JanusTan/robot_4_drawingpic/ACS6502 2019-20 Sem 1 Group Project Final Report Group 16.pdf

ACS6502 2019-20 Group Project Final Report

### ACS6502 Group Project Final Report

Group number 16, Domain 1, Autonomous systems

## Self - Drawing Manipulator

Ming Zhou, Zhaoda Du, Jiannan Tan ABSTRACT — The aim of this project is to design a manipulator that can draw picture according to the user's needs. The user only needs to insert an image file in the user interface, and the manipulator can draw it on the paper. Manipulator is now used in many fields, such as industrial production and medical treatment. It can accomplish many tasks that human beings can't, characterized by high precision, large load and long continuous operation time. In order to realize the drawing function of the manipulator in this project, the problems faced are: mechanical and electronic design, the image processing, how to control the joint of the manipulator so that it can accurately guide the end-effector (such as pen) to the corresponding position. The system is divided into two parts, image processing and servo motor control. To assess the performance of the design, a random 30-person survey was conducted. The result is quite successful. The project can improve for other functions, only thing need to replace the end-effector.

### 1. INTRODUCTION

With the development of computer imaging, the traditional drawing tools have changed. Computer graphics has become a mainstream productivity tool. But ink-pan painting is still very popular in the field of art [1]. It has its own unique artistic value. Many people dream of creating their own ink-pan paintings, but it is very difficult to master such a skill. Even some artists often spend a lot of time to create ink-pan paintings. With this motivation, the group decided to develop a drawing manipulator that can realize the creation of ordinary people's ink-pan painting. There are many similar projects in the field of robot drawing. For example, ISAC [2] learns to draw by tracking human hand movements. Draw-Bot [3] analyzes and records the force between pen and paper to learn how to draw. Both of the above projects have a similar feature. It is necessary to learn the artist's painting process before drawing an ink-pan painting. The disadvantage is that such robots can only draw a single ink-pan painting, which can’t meet the flexible needs of ordinary users. In addition, the drawing manipulator can also be used for drawing education. The beginners can learn some drawing skills by repeatedly observing the drawing track of the manipulator. For example, a drawing education mechanical arm developed with Lego building blocks [4].

### 2. DEVELOPED SYSTEM

### 2.1 OVERVIEW OF THE SYSTEM

Fig. 1 presents the CAD design of the drawing robot system. The arm 1 and arm 2, which are controlled by motor 1 and motor 2 respectively, should move from 0° to 179°. Before the manipulator begins to draw, the end-effector would be pressed down by the motor 3. After the manipulator completes a continuous curve, the end-effector would be lifted by the motor 3 and prepares for the next point.

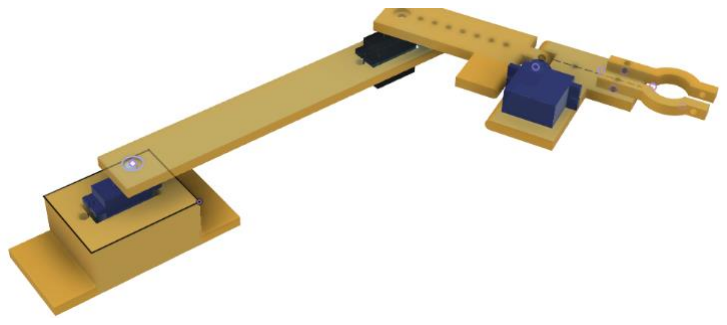
[picture p1: figure]

Fig. 1. Overview of the CAD design of the system.

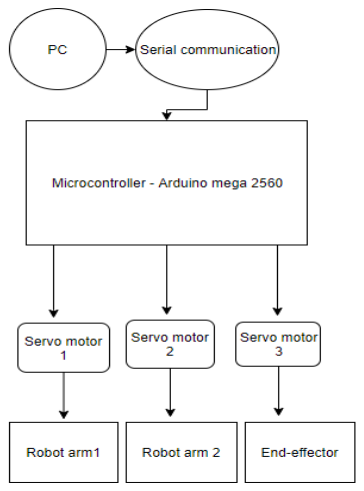
[picture p2: figure]

Fig. 2. Components relation diagram describing the system’s functional structure.

Fig 2. shows the connection between the joints and MCU to realize the mechatronic behaviour that draws pictures on paper. After the picture was processed by PC or other microcontrollers, the coordinates of the picture would be sent to Arduino Mega 2560 via serial communication.

### 2.2 MECHANICAL DESIGN

All mechanical parts in this project are manufactured by 3D printer with PLA material. The 3D model is designed from Fusion 360. The appearance of the real manipulator shows in Fig.3 below.

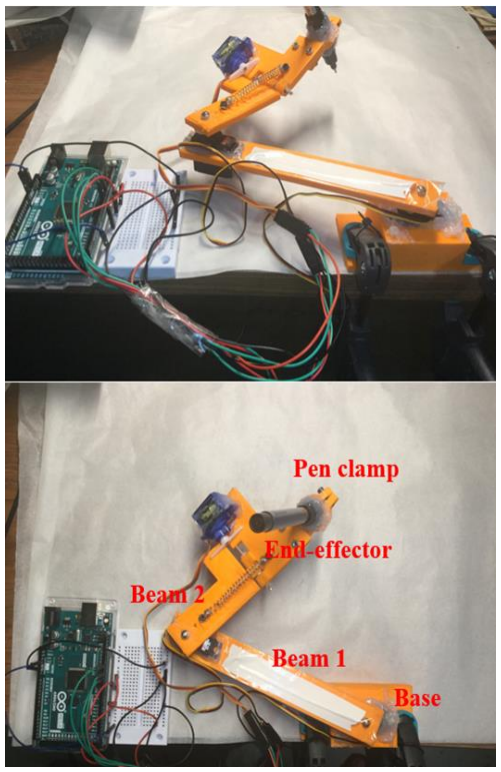
[picture p3: figure]

Fig. 3. The real Mechanical design of this manipulator.

This manipulator contains 5 parts, they are Base, Beam 1, Beam 2, End-effector and Pen clamp(They have been marked named in Figure 1). They can be viewed separately in fusion 360 and the parameters of each part shown in Fig. 4 (top view parameters) and Fig. 5 (side view parameters). (they have been put in appendix)

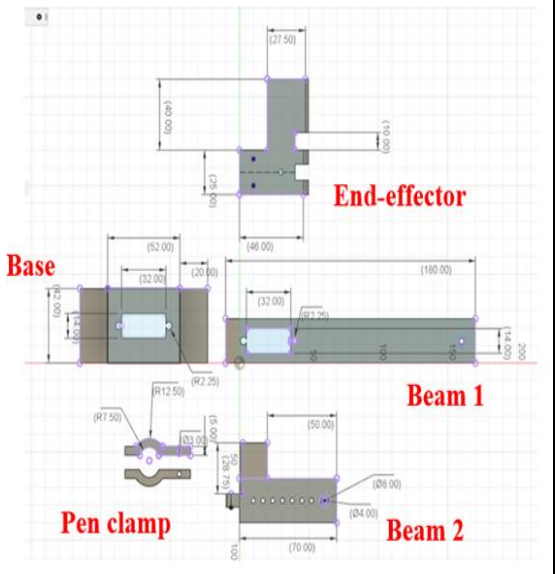
[picture p4: figure]

Fig. 4. Top view parameters of each part.

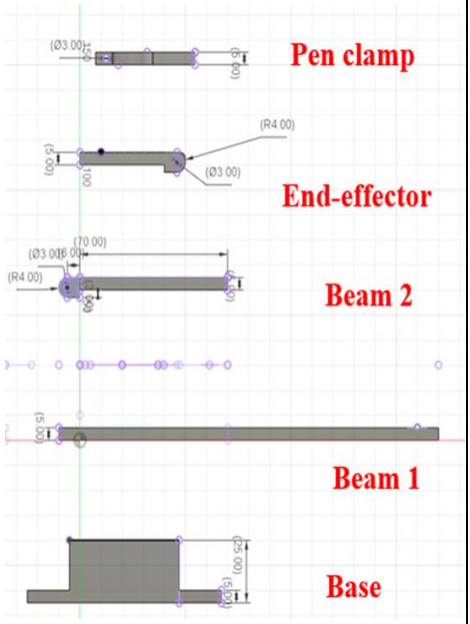
[picture p5: figure]

Fig. 5. Side view parameters of each part.

To assemble the parts, screws and hot gun have been used. The structure of this manipulator is strong enough to operate. A spring has been connected between end-effector and beam 2, that’s why there are many holes in the centre of beam 2, spring can be stretch according to the torque of the motor on end-effector.

### 2.3 ELECTRONICS DESIGN

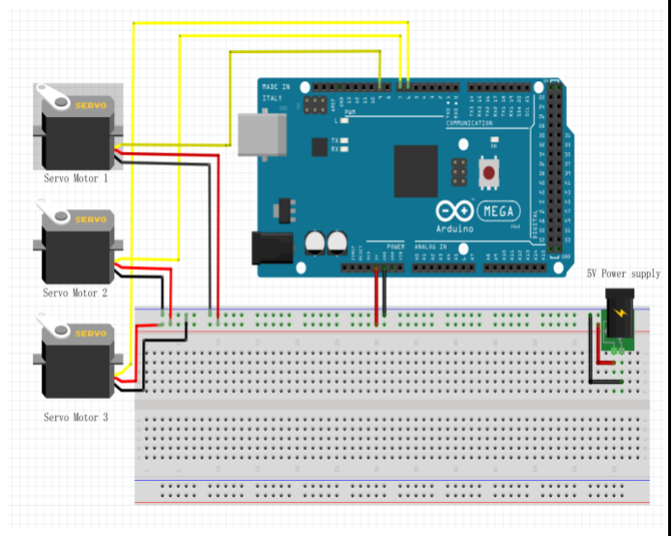
[picture p6: figure]

Fig. 6. Schematic and photo of the circuit.

Fig 6. shows the circuit of the system. Two Servo motors (HS-81) [5] have been selected for joint 1 and joint 2, respectively. The torque for these two
motors | was | 3 | kg·cm | which | satisfies | the
requirements for driving the weights (80g±2g) of all robot arms and a pen. The torque of another servo motor (SG90) [6] for joint 3 was 2.5 kg·cm. Because the motor for joint 3 was used for pressing down or lifting the pen, the requirement of the torque for implementing this operation is smaller than previous joints. Hence, using this servo motor is sufficient.

### 2.4 BEHAVIOUR DESIGN

In this project, inverse kinematic will be used. The equation of inverse kinematic shows as below.

Where:

θ1 is the turning angle of the motor at joint 1;

θ2 is the turning angle of the motor at joint 2;

l1 is the length from the first joint to the second joint;

l2 is the length from the second joint to pin of the pen;

x and y are the coordinates of
the pen.

l1, l2 are constant values and they are 145mm and 125mm.x and y are required input variables in this equation.

The working process of this project can be expressed in following Flowchart in Fig.7

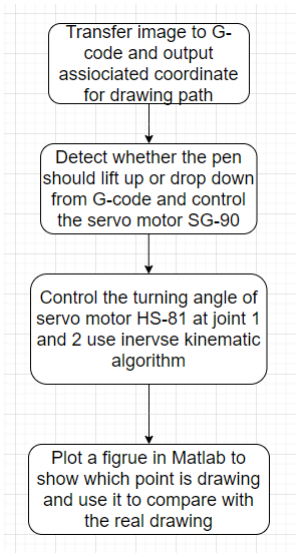
[picture p7: figure]

Fig. 7. Flow chart of the main algorithm

According to Fig.7, this project contains four parts.

Firstly, no matter what image has been downloaded from the website, the image will be put into a code (details of code please check Appendix) to transfer the image to G-code and therefore edge of the image will be detected. The coordinates (x, y) of points on edge will be put into a matrix, the matrix then separated into different paths. At the start of each path, a string ‘M3’ will be recorded and at the end of each path, a string’M5’ will occurs. Example of output data can be viewed in Fig. 8. G1 in Fig.8 means on the path. G90 means the start of the whole drawing process. A back up plan incase this code runs any problem in tests is to use a G-code software called ‘laser GRBL’.

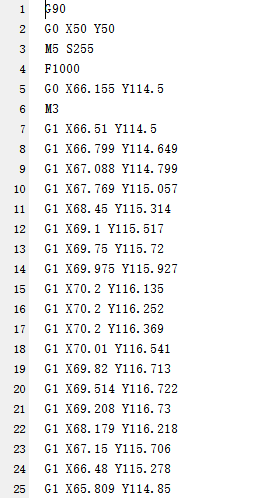
[picture p8: figure]

Fig. 8. Example of output data.

Secondly, string ‘M3’ and ‘M5’ will tell the SG90 motor to drop the pen down or lift the pen up. ‘M3’ means start drawing a new path, therefore pen should be drop down on the paper when’M3’ detected. On the contrast, ‘M5’ means lift the pen up to leave the paper and move to the start point of next point. (check the second code in Appendix)

Thirdly, the rotation angles of HS 81 servo motors will be controlled use inverse kinematic. (second code in Appendix).

Fourthly, a figure will be plot through the Matlab, to monitor the process by add point to this figure when running the manipulator. Fig. 9 is example of the plot figure. This is a minor of real figure.

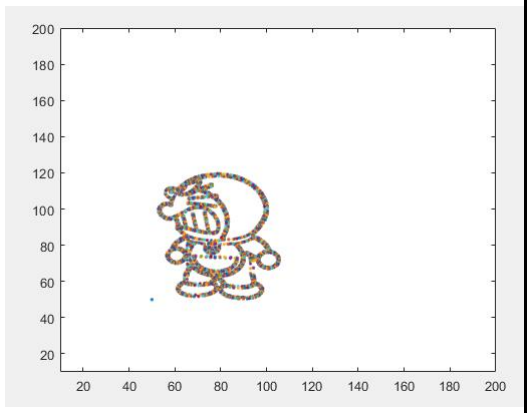
[picture p9: figure]

Fig. 9. Example of plot during process.

### 2.5 CHARACTERISATION

The particularity of this design is that it can't evaluate the result with intuitive data. The group chose to use the form of a questionnaire to 30 randomly selected students from the University of Sheffield. The results are analyzed and evaluated.
⚫ | Venue: Diamond, University of Sheffield
⚫ | Time: 13:25 - 14:57, 16 / 12 / 2019
⚫ | Form: Each of the group are randomly looking
| for 10 students on the first floor, the second floor
| and the third floor of the Diamond. Let them
| evaluate the ink-pan painting drew by the
| manipulator. There are five levels of evaluation,
| unrecognized at all, recognized but terrible, not
| bad, good and perfect.
The pictures evaluated are shown in the figure below. It's a cartoon character image

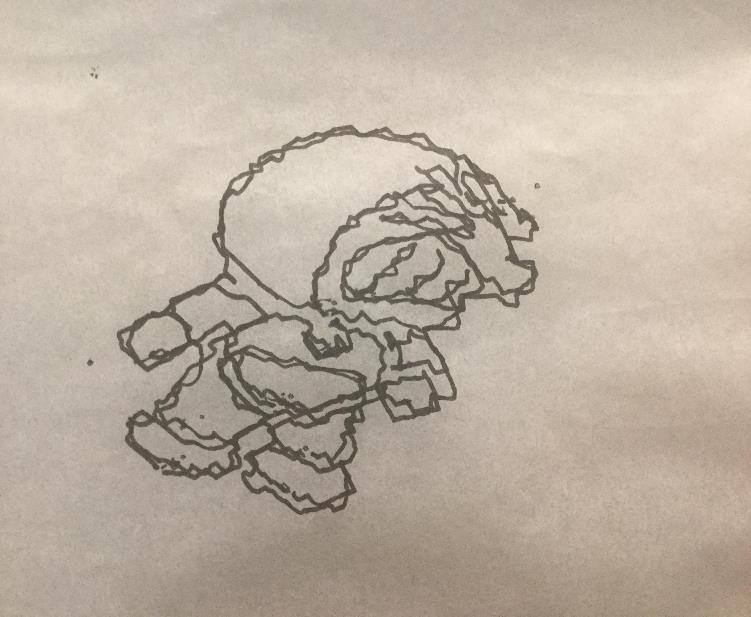
[picture p10: figure]

Fig. 10. Drawing results for survey

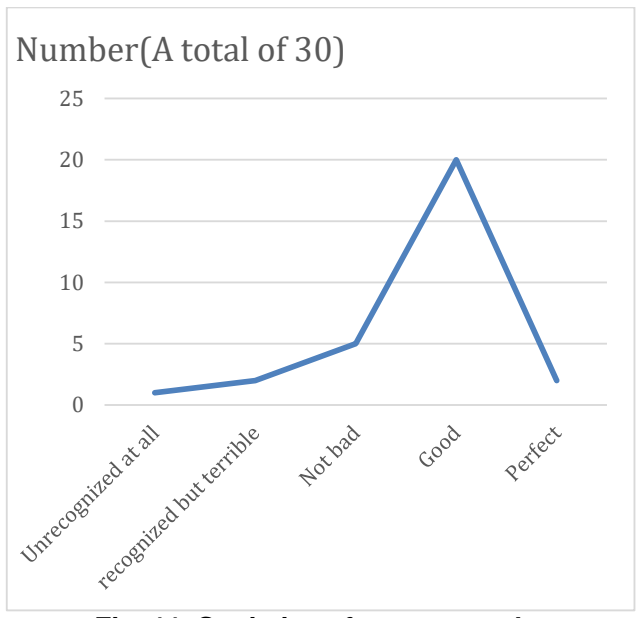
[picture p11: figure]
Number(A total of 30)

Fig. 11. Statistics of survey results
As can be seen in Fig.11, there are twenty students thought the picture was good, two thought it was perfect, five thought it was not bad, another two thought it could be recognized but it was bad, and one thought it couldn't be recognized.
From this statistic, 90% of the students hold a positive attitude towards the result. About 73% of the students praised it. From the above results, this project can be accepted by people and has certain value.

### 2.6 OTHER ISSUES, if any

None

### 2.7 LIST OF OUTSOURCED MATERIALS

The original implementation idea came from [7]. However, the program provided in this article does not work successfully on the platform of this project. Moreover, the image processing and path planning methods proposed in this article are two different methods from this report. In the initial realization of path planning, path planning generation software of laser cutting was used [8]. Based on the operating principle of this non-open source software, a program for image processing and path planning was written in this project.

### 3. DISCUSSION

This project has fully achieved the purpose of it and received a high level. Audiences that have not seen the original image can recognize what has been drawn by the manipulator. However, the drawing is still not accurate enough, this is limited by the hardware. Servo motor is not the best motor to make a drawing robot, but the limit of budgets is 40 pounds and many step motors are expensive than 20 pounds. This structure and material is not suited for long term use, but enough to finish this project and tests. A stronger structure and material should be used in future design (eg, Aluminium)

### 4. ACKNOWLEDGEMENT

All the three members of this group want to thank Dr. Shuhe Miyashita, Dr. Dana Damian, Dr Ben Taylor and all the GPAs. The group would also like to thank the 30 students who participated in the survey.

### 5. REFERENCES

[1] Y. Lu, H. M Lam, Y. Yam, “Preliminary Study on Vision-based Pen and Ink Drawing by a Robotic Manipulator, International Conference on Advanced Intelligent Mechatronics, 2009.
[2] A. Srikaew, M. E. Cambron, S. Northrup, R. A. Peters II, M. Wilkes, and K. Kawamura, “Humanoid drawing robot,” in IASTED International Conference on Robotics and Manufacturing, 1998.
[3] P. Monaghan, “An art professor uses artificial intelligence to create a computer that can draw and paint,” The Chronicle of Higher Education, 2012.
[4] A´. Ha´mori, J. Lengyel, and B. Resko, “3DOF drawing robot using LEGO-NXT”, International Conference on Intelligent Engineering Systems, June 23–25, 2011.
[5] | Anon, | (2019). | [online] | Available | at:
https://www.robotshop.com/media/files/pdf/hs81.pd f [Accessed 20 Dec. 2019].
[6] Ee.ic.ac.uk. (2019). [online] Available at: http://www.ee.ic.ac.uk/pcheung/teaching/DE1_EE/stores/sg90_datasheet.pdf [Accessed 20 Dec. 2019].
[7] Instructables, “Drawing Robot,” Instructables,
13-Oct-2017. | [Online]. | Available:
https://www.instructables.com/id/Drawing-Robot. [Accessed: 20-Dec-2019].
[8] | LaserGRBL. | [Online]. | Available:
http://lasergrbl.com/. [Accessed: 20-Dec-2019].

### 6. REFLECTIONS

Considering the difficulty and complexity of this project, we started to prepare for this project very early. In week 3, our group plans to have an offline group discussion every week. At first, everyone put forward various ideas and then analyzed and discussed them. After the experimental classes every week, we asked GTA some ideas about our project. Such as the feasibility of this project, the estimation of budget, what knowledge and technology will be used. We have recognized the painting robot proposed by Tan. We held the view that making this robot is very interesting. After looking up information online, we found that we needed to use much new knowledge, such as image processing, inverse kinematics, and path planning, which made us very excited. In the fifth week, we started the division of labour. Tan is responsible for image processing, Zhou is responsible for circuits and Arduino, and Du is responsible for robot kinematics and mechanical production. It did not go well at first. Du proposed a strategy of traversing all the pixels, but the robot was running very slowly and could not even draw a circle in 10 minutes. When we were at a loss, Tan got the inspiration from iForge's
laser | cutting | machine. | After | searching | the
information on the Internet, we found a thing called G-code that can be used to plan the drawing path of the robotic arm, and we figured out how to generate gocode by our own program.
After | going | through
mechanical production and debugging, the robot can successfully draw very complicated pictures.

Appendix A: WEEKLY REPORT ATTACHMENT

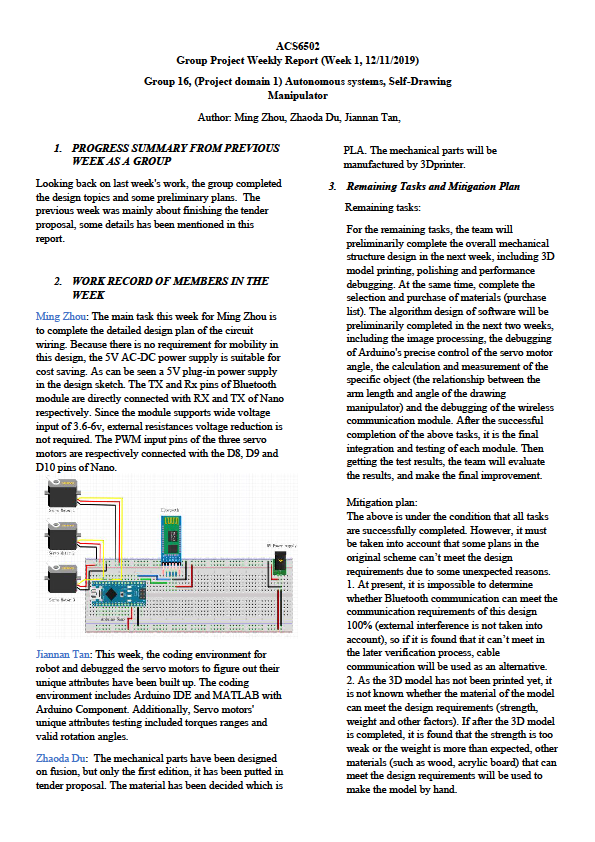
[picture p12: figure]

WEEKLY REPORT 1

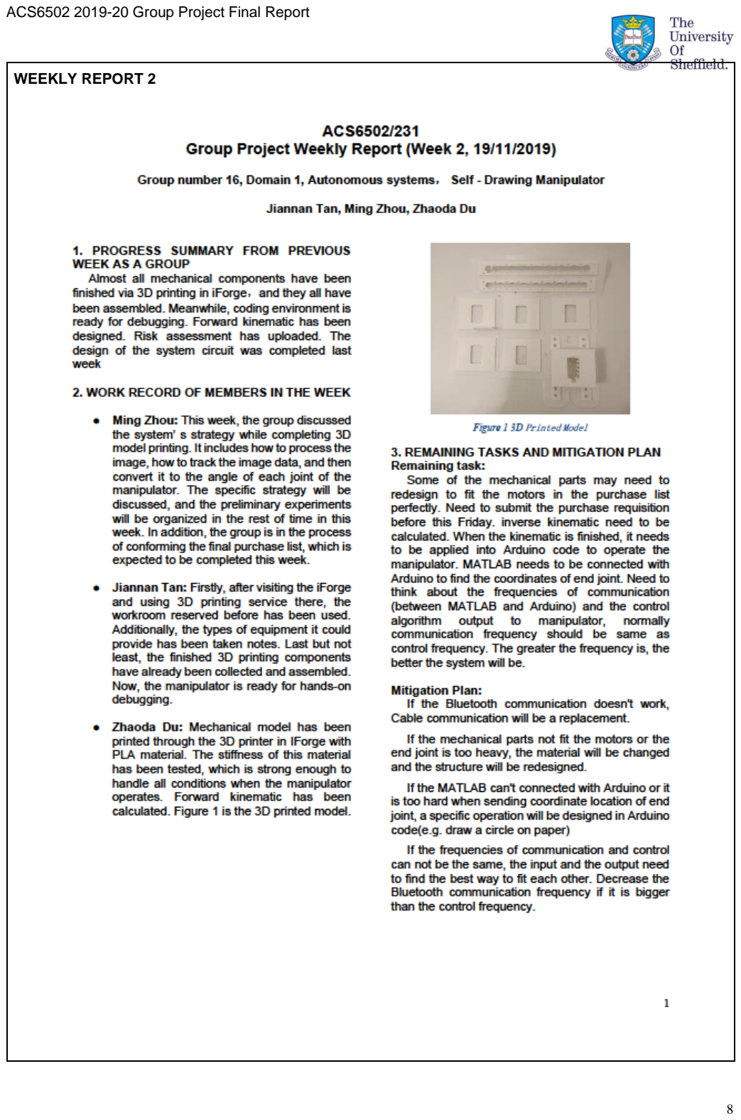
[picture p13: page 8]

WEEKLY REPORT 2

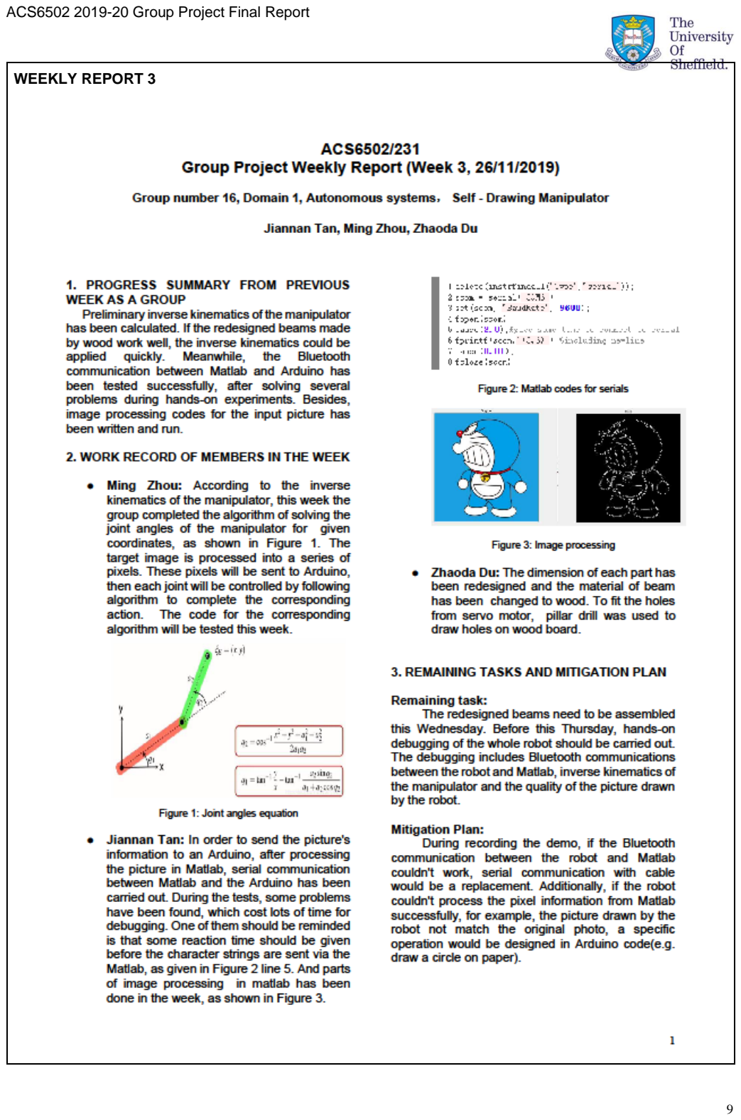
[picture p14: page 9]

WEEKLY REPORT 3

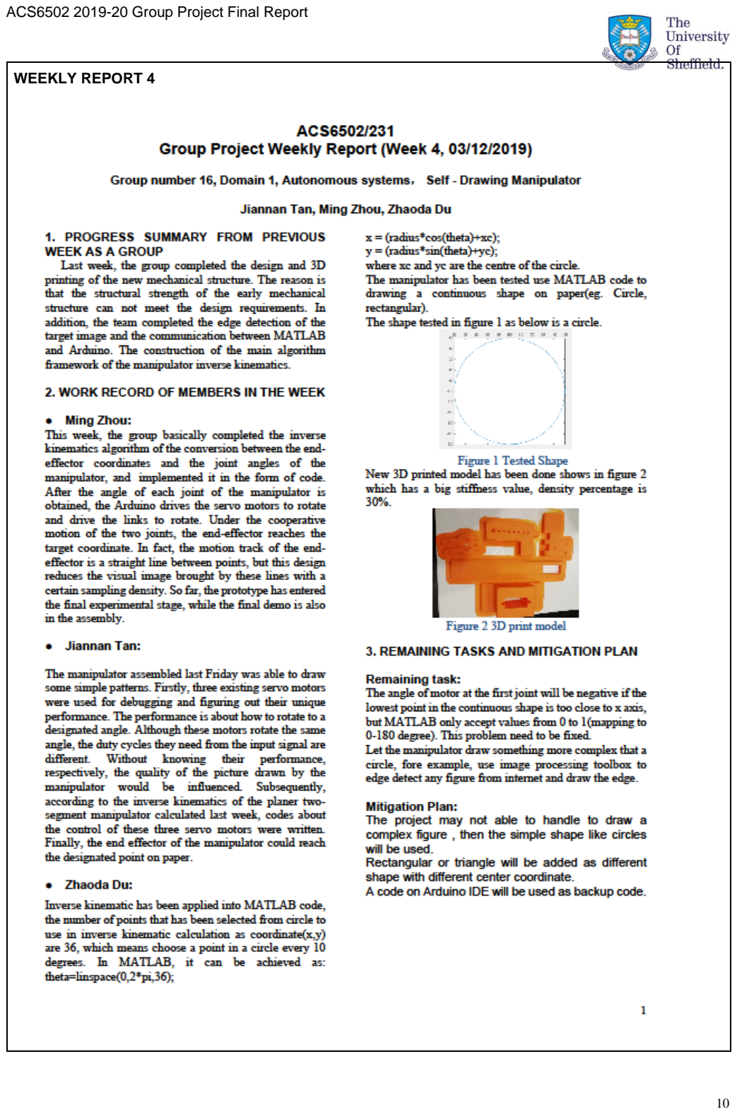
[picture p15: page 10]

WEEKLY REPORT 4

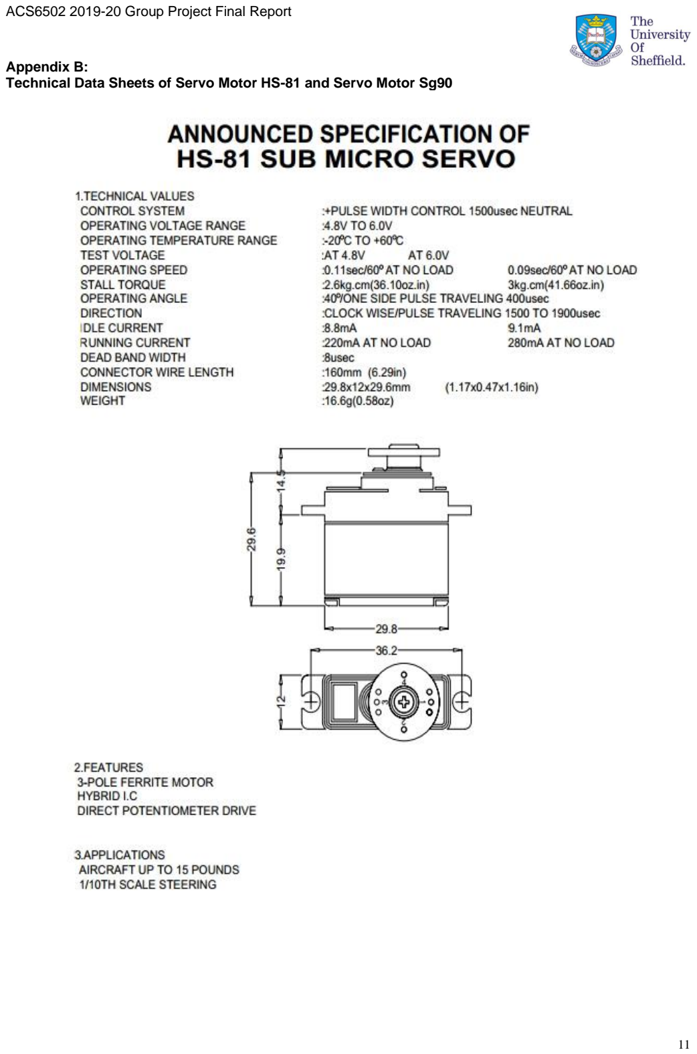
[picture p16: page 11]

Appendix B:
Technical Data Sheets of Servo Motor HS-81 and Servo Motor Sg90

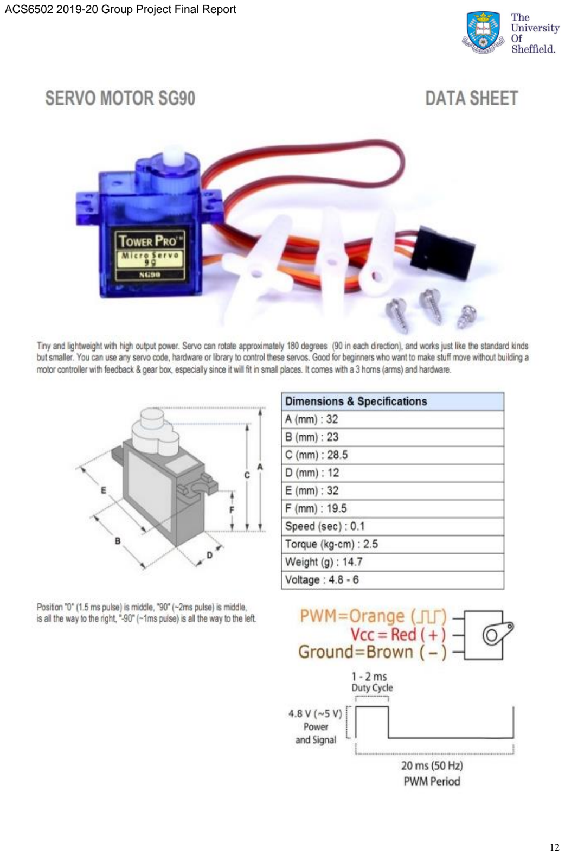
[picture p17: page 12]

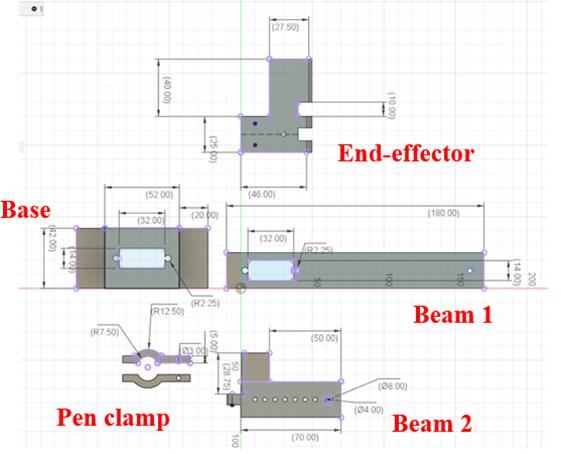
[picture p18: figure]

Parameters of mechanical elements

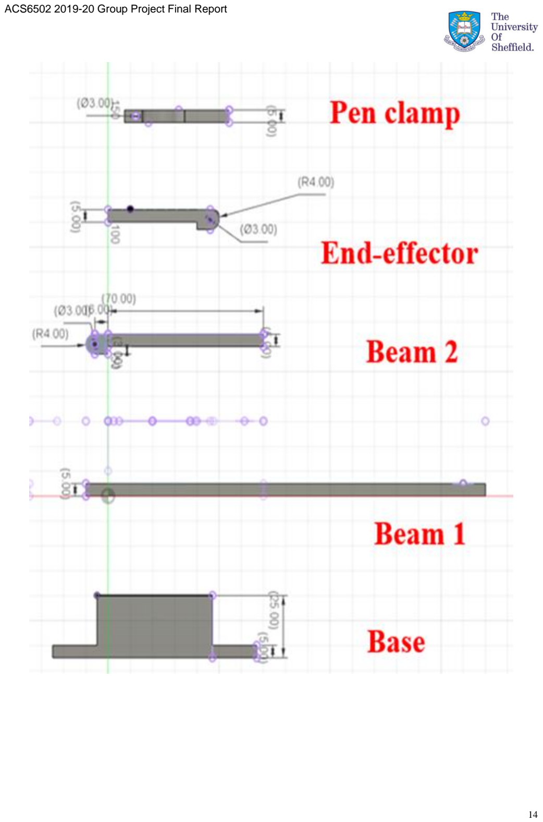
[picture p19: page 14]

Code
Code for G-code transfer(python)
1. from __future__ import absolute_import, division, print_function, unicode_literals
2. import os
3. import sys
4. import cv2
5. import termcolor
6. import ast
7. import copy
8. import argparse
9.
10.
11. class ImageToGcode():
12. def __init__(self,
13. img,
14. verbose=False):
15. self.img = cv2.imread(img,0)
16. self.output = ""
17. self.outFile = os.path.splitext(os.path.abspath(img))[0]+".gco"
18. self.spread = 3.175
19. self.nozzles = 12
20. self.increment = self.spread/self.nozzles
21. self.printArea = [200, 200]
22. self.feedrate = 1000
23. self.black = 255
24. self.offsets = [0, 0]
25. self.debug_to_terminal()
26. self.make_gcode()
27.
28. def make_gcode(self):
29. self.output = "M106" #Start Fan
30. nozzleFirings = [0 for x in range(0, self.img.shape[1])]
31. nozzleFirings = [copy.copy(nozzleFirings) for x in range(0, 4)]
32. scan = range(0, self.img.shape[0])
33. scan.reverse()
34. for y in scan:
35. for x in range(0, self.img.shape[1]):
36. color = self.img[y,x]
37. if color == self.black:
38. nozzleFirings[3][x] += 1 << y % self.nozzles
39. else:
40. pass
41. if y % 12 == 0 and y > 0:
42. for headNumber, headVals in enumerate(nozzleFirings):
43. for column, firingVal in enumerate(headVals):
44. if firingVal:
45. #print(headNumber)
46. currentOffset = self.offsets
47. self.output += "G1 X"+str(self.increment*column-currentOffset[0])+" Y"+str(y/12*self.spread-currentOffset[1])+" F"+str(self.feedrate)+"\n"
48. self.output += "M400\n"
49. self.output += "M700 P"+str(headNumber)+" S"+str(firingVal)+"\n"
50. #print (self.output)
51. nozzleFirings = [0 for x in range(0, self.img.shape[1])]
52. nozzleFirings = [copy.copy(nozzleFirings) for x in range(0, 4)]
53. f = open(self.outFile, 'w')
54. f.write(self.output)
55. f.close()
56.
57. def debug_to_terminal(self):
58. print("Rows: "+str(self.img.shape[0]))
59. print("Cols: "+str(self.img.shape[1]))
60. print("Spread: "+str(self.spread)+"mm")
61. print("Nozzles: "+str(self.nozzles))
62. print("Print Area: "+str(self.printArea)+"mm")
63. rowStr = ""
64. for y in range(0, self.img.shape[0]):
65. rowStr = ""
66. for x in range(0, self.img.shape[1]):
67. color = self.img[y, x]
68. if color == self.black:
69. rowStr += " "

70. else:
71. rowStr += termcolor.colored(" ", 'white', 'on_white')
72. print (rowStr)
73.
74.
75. if __name__ == "__main__":
76. #Setup Command line arguments
77. parser = argparse.ArgumentParser(prog="image-to-gcode.py",
78. usage="%(prog)s [options] input...",
79. description="Convert bitmaps to gcode."
80. )
81.
82. parser.add_argument("input",
83. help="input file, defaults to stdin"
84. )
85. parser.add_argument('--version',
86. action='version',
87. version="%(prog)s 0.0.1-dev"
88. )
89.
90.
91. #Always output help by default
92. if len(sys.argv) == 1:
93. parser.print_help()
94. sys.exit(0) # Exit after help display 95.
96. args = parser.parse_args()
97.
98. imageProcessor = ImageToGcode(img=args.input,
99. )

Code for control algorithm(Matlab) clear all;
% port at which your arduino is connected port = 'COM9';
% model arduino board
board = 'Mega2560';
% creating arduino object with servo librarytheta2 arduino_board = arduino(port, board, 'Libraries', 'Servo'); % creating servo motor object
servo_motor1 = servo(arduino_board, 'D9'); servo_motor2 = servo(arduino_board, 'D7'); servo_motor3 = servo(arduino_board, 'D6'); theta3 = 0.63;
theta4 = 0.4;
L1=145;
L2=125;
fid=fopen('dola1.nc');

while ~feof(fid)
str = fgetl(fid);
if ((str(1)=='G')&&(str(2)=='1'))||((str(1)=='G')&&(str(2)=='0')) % control rotation angle of HS81 servo motors data=regexp(str,'\d*\.?\d*','match');
a=data{2};
b=data{3};
X=str2double(a);
Y=str2double(b);
disp([X,Y]);
plot(X,Y,'.');
axis([10 200 10 200]);
hold on;
theta2 = (acos((X^2+Y^2-L1^2-L2^2)/(2*L1*L2)))*(1/180)*(180/pi);
theta1 = (atan(Y/X)-atan((L2*sin(theta2))/(L1+L2*cos(theta2))))*(1/180)*(180/pi); writePosition(servo_motor1, theta1);
writePosition(servo_motor2, theta2);
pause(0.01);

end
if (str(1)=='M')&&(str(2)=='3') % drop the pen down

writePosition(servo_motor3, theta3);
pause(0.5);
end
if ((str(1)=='M')&&(str(2)=='5'))||((str(1)=='G')&&(str(2)=='9')) % lift pen up writePosition(servo_motor3, theta4);
pause(0.5);
end
end
