JanusTan/robot_4_drawingpic/(list of files, cad)

Other CAD files:
mechanical parts design.f3z
